cmd-robotics/kicadLibs/README.md

This repository contains KiCad parts used in our devices

# usage
1. pull the repository
2. open KiCad
3. open menu -> Preferences -> Configure Paths
4. hit the [+] button at the bottom, add CMD_R_3DMODEL_DIR variable, and assign it the path of the pulled directory, then [OK]
5. open menu -> Preferences -> Manage Symbol Libraries
6. hit the [📁] button at the bottom, navigate to the pulled directory, and select all *.kicad_sym files, confirm by [Open], then [OK]
7. open menu -> Preferences -> Manage Footprint Libraries
8. hit the [📁] button at the bottom, navigate to the pulled directory, select it by clicking [Open], then [OK]
9. restart KiCad
