cmd-robotics/kicadLibs/rnx0012b.step

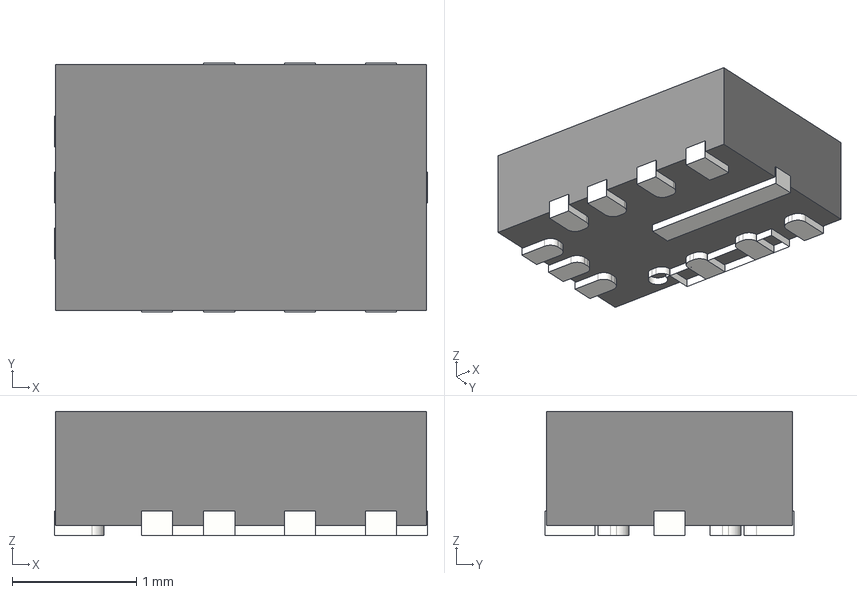
[picture p1: CAD file, 2025-07-31]
rnx0012b.step
3.00 x 2.00 x 1.00 mm
