cmd-robotics/kicadLibs/XT30U-M.step

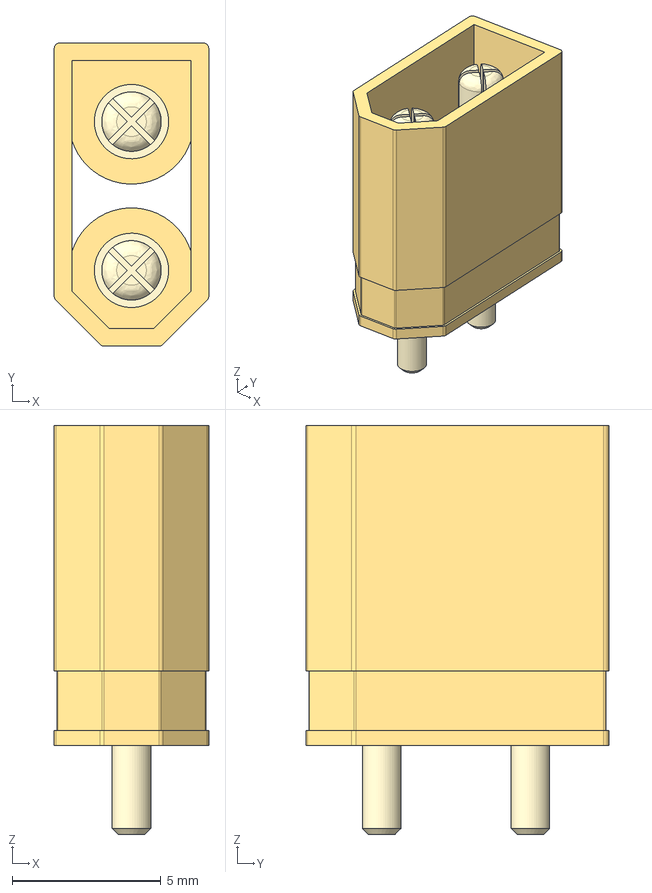
[picture p2: CAD file, 2025-06-14]
XT30U-M.step
5.20 x 10.2 x 13.8 mm
