cmd-robotics/kicadLibs/Allegro_QNF-EX.step

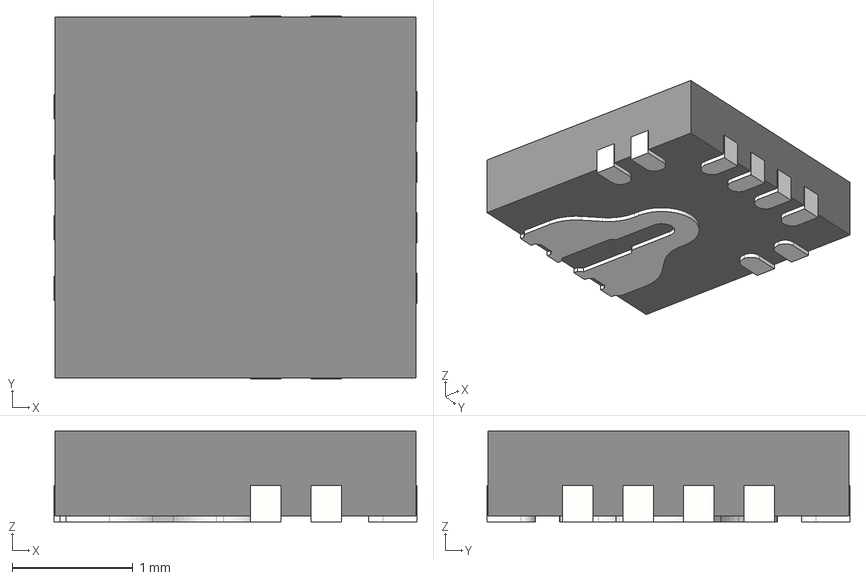
[picture p3: CAD file, 2024-11-04]
Allegro_QNF-EX.step
3.00 x 3.00 x 0.75 mm
