cmd-robotics/kicadLibs/Recom RxxC1TFxxS.step

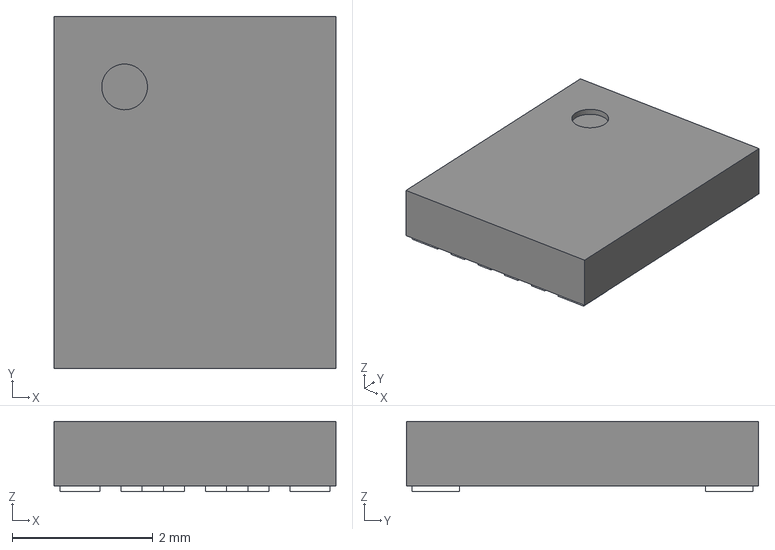
[picture p4: CAD file, 2024-11-04]
Recom RxxC1TFxxS.step
4.00 x 5.00 x 1.00 mm
