cmd-robotics/kicadLibs/easv2713rgba.step

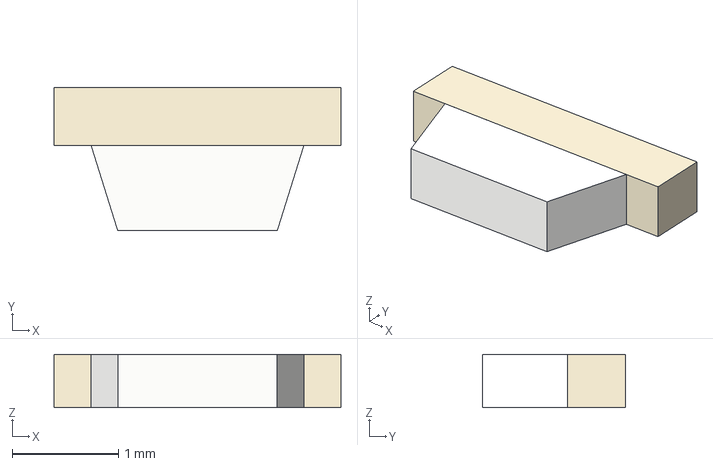
[picture p5: CAD file, 2024-10-31]
easv2713rgba.step
2.70 x 1.35 x 0.5 mm
