cmd-robotics/kicadLibs/R-667799.step

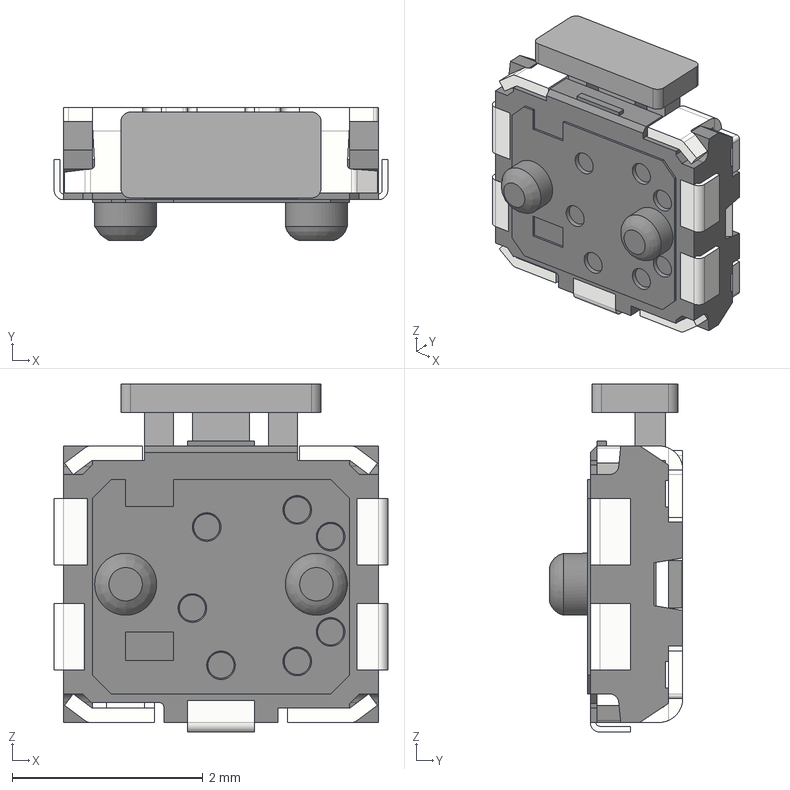
[picture p6: CAD file, 2024-10-31]
R-667799.step
3.50 x 1.40 x 3.65 mm
SOU_BASE
SOU_TERMINAL
SOU_SLIDER
SOU_COVER
