cmd-robotics/kicadLibs/EVQPU-JA-02K.STEP

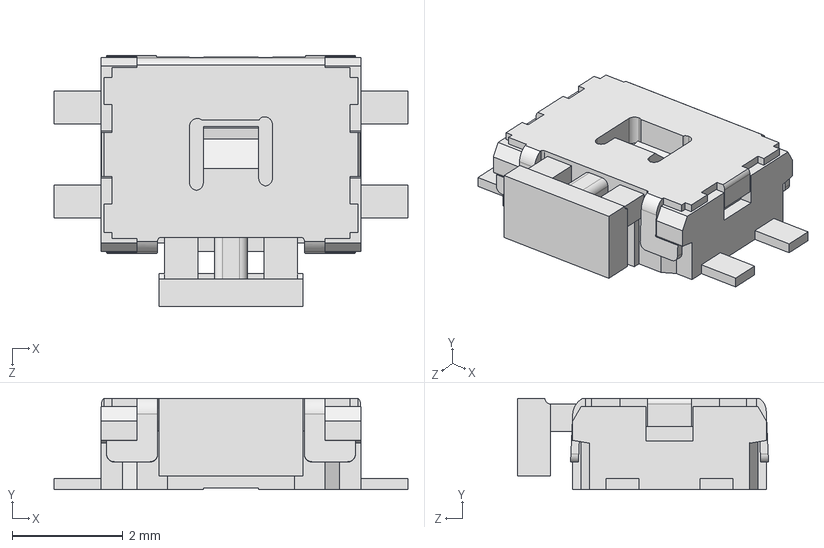
[picture p7: CAD file, 2024-10-29]
EVQPU-JA-02K.STEP
6.40 x 1.65 x 4.54 mm
