cmd-robotics/kicadLibs/B0505MT-1WR4.step

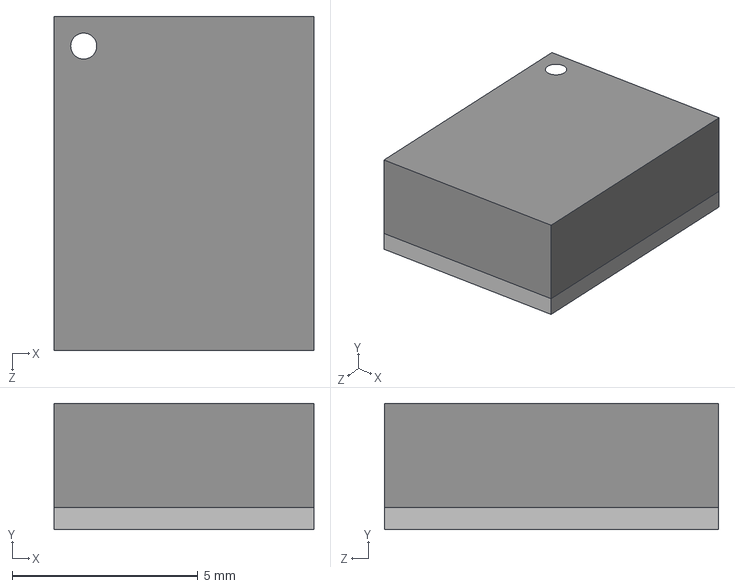
[picture p8: CAD file, 2024-10-29]
B0505MT-1WR4.step
7.00 x 3.40 x 9.00 mm
