cmd-robotics/kicadLibs/7689.step

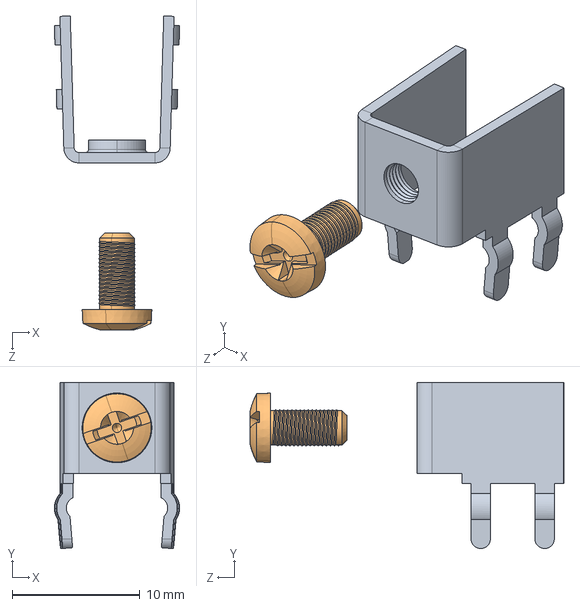
[picture p9: CAD file, 2024-10-29]
7689.step
9.81 x 13.0 x 24.6 mm
