cmd-robotics/kicadLibs/WSK1216.step

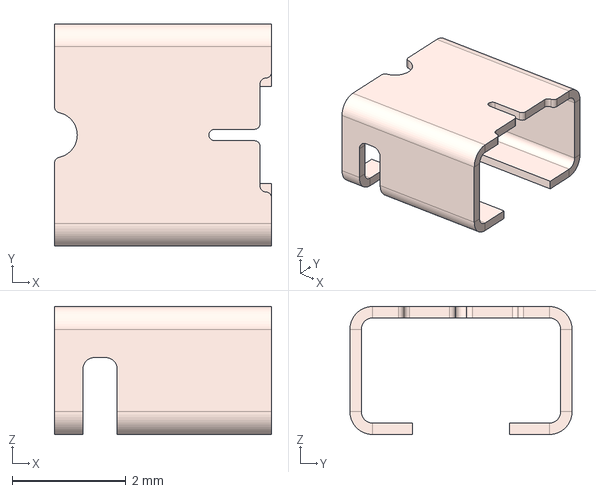
[picture p10: CAD file, 2023-12-26]
WSK1216.step
3.81 x 3.90 x 2.25 mm
