cmd-robotics/kicadLibs/MR30PW-F.iges

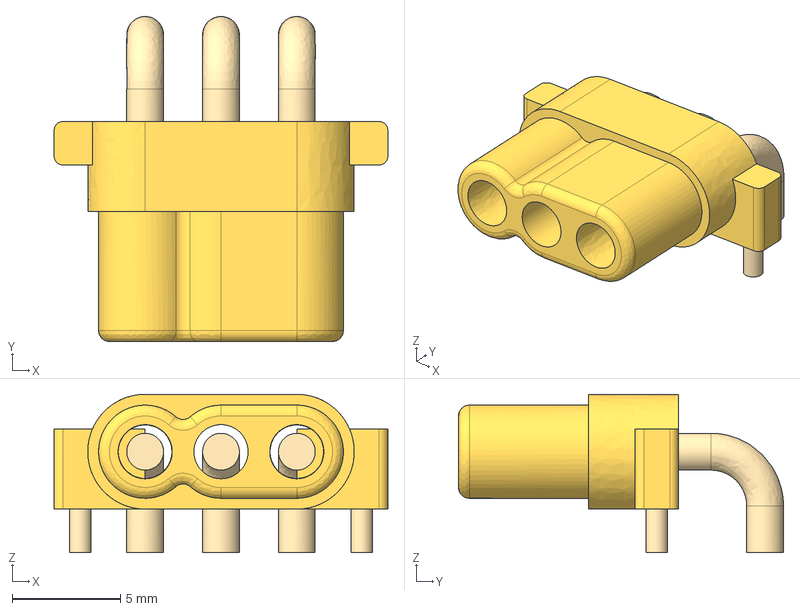
[picture p11: CAD file, 2023-08-18]
MR30PW-F.iges
15.4 x 15.0 x 7.31 mm
