cmd-robotics/kicadLibs/MR30PW-M.iges

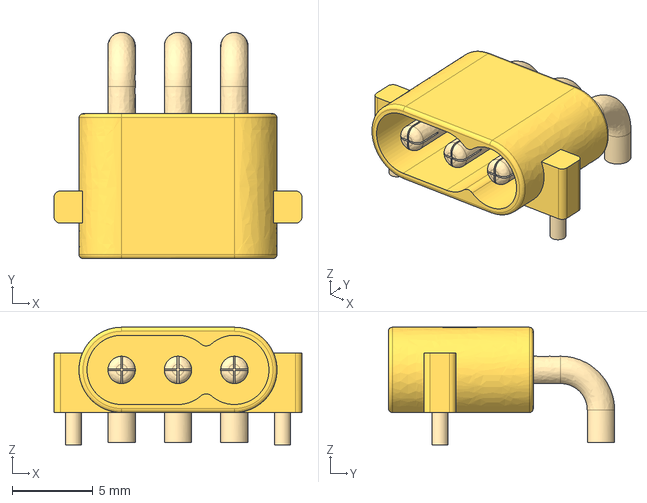
[picture p12: CAD file, 2023-08-18]
MR30PW-M.iges
15.4 x 14.0 x 7.30 mm
