cmd-robotics/kicadLibs/XT30M.iges

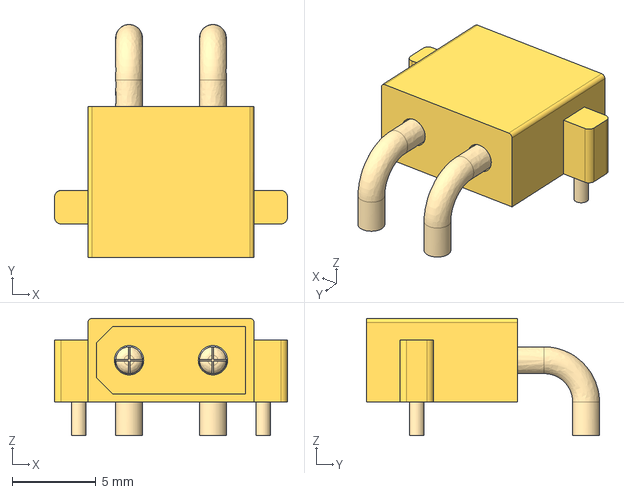
[picture p13: CAD file, 2023-08-18]
XT30M.iges
13.9 x 13.9 x 7.00 mm
