cmd-robotics/kicadLibs/504195-0270.stp

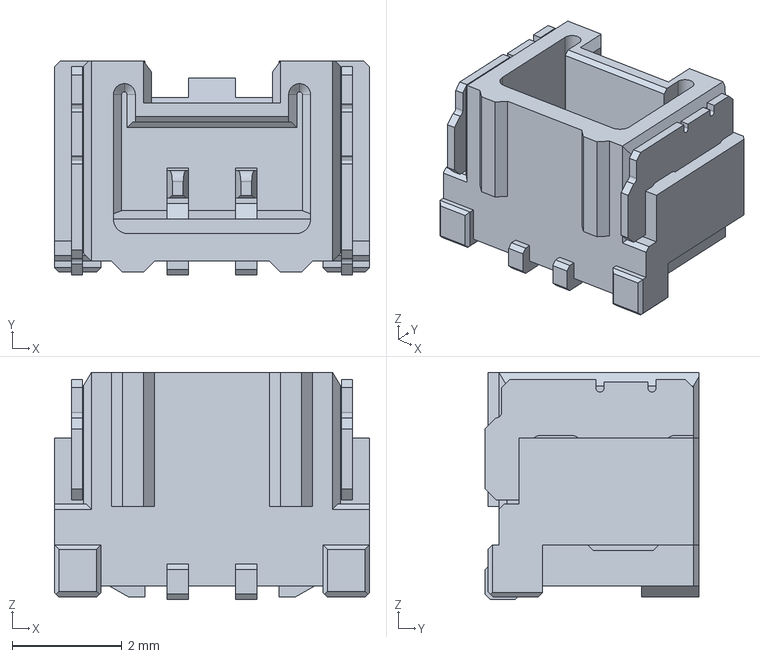
[picture p14: CAD file, 2024-10-29]
504195-0270.stp
5.75 x 3.90 x 4.15 mm
