cmd-robotics/kicadLibs/2005280050.stp

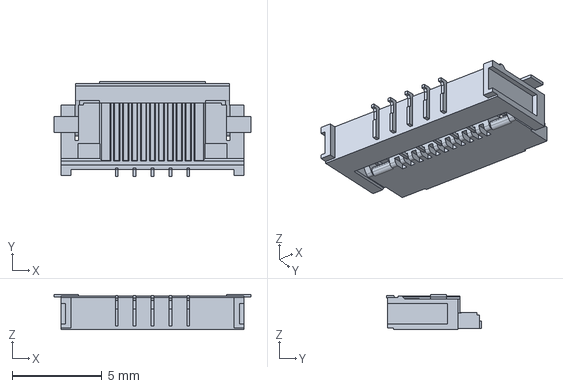
[picture p15: CAD file, 2024-10-29]
2005280050.stp
11.0 x 5.30 x 1.96 mm
