cmd-robotics/kicadLibs/CSD88584Q5DC.step

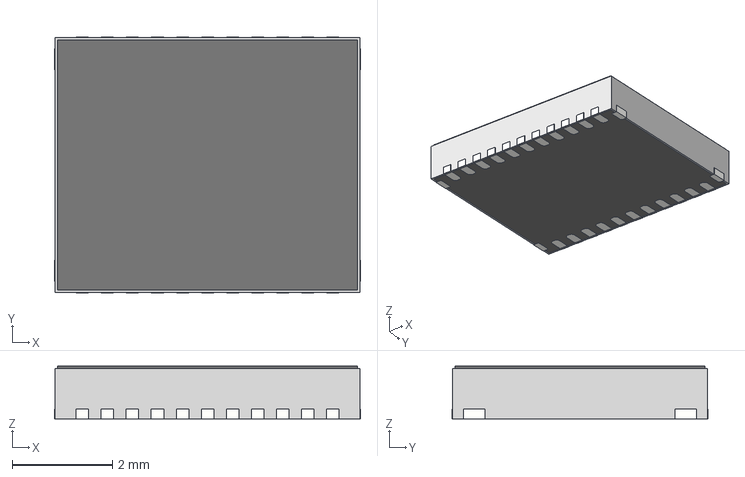
[picture p16: CAD file, 2023-12-26]
CSD88584Q5DC.step
6.12 x 5.12 x 1.05 mm
