cmd-robotics/kicadLibs/(list of files, cad)

Other CAD files:
XT30U-M.iges
