cmd-robotics/kicadLibs/(commit log)

2023-04-22 nRF52833 and an RF switch
2023-04-25 adding a few footprints
2023-04-28 improving the NFC antenna pins connections
2023-04-28 adding mirrored nRF BLE antenna
2023-04-29 added a via-stitched SO-8 MOSFET and removed clearance violation on the funky QFN-18
2023-08-11 starting the BLDC motion controllers library
2023-08-18 adding XT30 sockets: 2- and 3-prong
    [MR30PW-M.iges, XT30M.iges]
2023-08-18 adding the MR30PW-F
    [MR30PW-F.iges]
2023-08-19 adding hall + temp sensor
2023-08-22 adding footprint used in DRV8311P
2023-08-30 updating the power pin
2023-12-09 adding the mid-board USB-C receptacle
2023-12-14 adding parts required for the CAN bridge and new angle sensors
2023-12-19 adding rotary switch for board ID
2023-12-26 adding a couple/few parts for the handcontroller MOSFET stage
2023-12-26 making the MOSFET's designator visible
2023-12-26 adding the shunt
    [WSK1216.step]
2023-12-26 making the pins of the MOSFET routable
2023-12-26 more adjustments to the MOSFET
    [CSD88584Q5DC.step]
2024-01-02 adding the 90-degree button with custom footprint and model
2024-02-04 adding power and flex connector parts used in hc.v.2
2024-02-09 adding the missing MOSFET pins
2024-03-25 adding STM32H563VG, fixing references, merging *.kicad_sym into a single file
2024-07-19 adding MLR33620 -- buck converter
2024-08-22 more convenient distance between pads for schematic routing
2024-10-29 adding the 3d model for RNX0012B (package for lmr33620)
    [rnx0012b.step]
2024-10-29 adding 3d models and fixing the paths to them
    [2005280050.stp, 504195-0270.stp, 7689.step, B0505MT-1WR4.step, EVQPU-JA-02K.STEP, XT30U-M.iges]
2024-10-31 adding a small SMD 90 degree button from Mistumi + some 3d models
    [R-667799.step, easv2713rgba.step]
2024-11-04 adding few 3d models
    [Allegro_QNF-EX.step, Recom RxxC1TFxxS.step]
2024-11-04 reducing the number of DRC warnings due to silkscreen overlapping the mask openings
2025-06-14 adding a new STM32C0 symbol
    [XT30U-M.step]
2025-07-31 catching up on a few footprint changes to meet the datasheet drawings
    [rnx0012b.step]
2025-08-04 separating stiffeners to two different user layers, depending on the connector side
